bynhack/rc-control/hardware/README.md

# hardware

Boards for the cars (KiCad). 車上用的電路板 · 车上用的电路板

- [`x2201-carrier`](x2201-carrier): a passive carrier board for the X2201 (极客者 1:22 crawler).

Docs: [English](../docs/en/hardware.md#x2201-carrier-board) · [繁體中文](../docs/zh-TW/hardware.md#x2201-轉接板) · [简体中文](../docs/zh-CN/hardware.md#x2201-转接板)
