bynhack/rc-control/docs/en/development.md

# Development

**English** | [繁體中文](../zh-TW/development.md) | [简体中文](../zh-CN/development.md)

## Firmware layout

All in [`firmware/wheel-esp32/main`](../../firmware/wheel-esp32/main):

| File | Role |
|---|---|
| `main.c` | Boot, USB host, and the hand-off from the wheel to the driving model |
| `wheel.c` | Parses the wheel base's HID reports, by VID:PID |
| `control.c` | The driving model and every safety rule. The radios only read `control_output()` |
| `radio.c` | Cars, settings in NVS, and the handling every radio goes through |
| `crsf.c` | ExpressLRS (CRSF) sender |
| `multi.c` | MULTI 4-in-1 sender, serial or PPM |
| `remote.c` | Toy remote through the MCP4728 DAC, and the serial console |
| `ffb.c` | Force feedback (USB PID) |
| `sound.c` | Engine sound synthesis |
| `display_p4.c`, `dash_p4.c`, `ui_p4.h` | Settings screens, instrument clusters, on-screen text in both languages |

`components/usb_host_hid` is a copy of Espressif's usb_host_hid 1.2.1 with one addition, explained under [Force feedback](#force-feedback).

### The signal path

```
wheel.c → control.c (driving model, safety) → radio.c (handling) → crsf.c / multi.c / remote.c
```

A new way of reaching a car only needs a sender that reads `control_output()`, passes it through `radio_steering()` and `radio_throttle()`, and turns the resulting −1…+1 into its own signal. Add it to `radio_kind_t` in `radio.h`, and it gets cars, handling, reverse and the safety rules for free.

### Responsiveness comes first

Nothing may delay the radio. The senders run on core 1 at the highest priorities:

| Task | Core | Priority |
|---|---|---|
| `crsf` | 1 | 10 |
| `multi` | 1 | 9 |
| `sound` | 0 | 6 |
| `ffb` | 0 | 4 |
| `remote` | 1 | 4 |
| `usb_lib` | 0 | 2 |
| `remote_con` (serial console) | 1 | 2 |
| `ui` | 1 | 1 |

The tuning page and the console sit below every sender, so they can't slow the car's response down. A simulated wheel (`w`) is ignored whenever the real wheel has sent data within the last 0.5 s.

### Force feedback

The force feedback reports have to go out on the HID interface's interrupt OUT endpoint (0x03 on the R5). If you send them with SET_REPORT on the control pipe, the R5 answers OK and does nothing. ESP-IDF's usb_host_hid doesn't support OUT endpoints, so `components/usb_host_hid` adds `hid_host_device_send_output_report()`. The effects also need their direction enabled and set to 90° (the X axis); otherwise the spring and damper have no force.

## Serial console

The console is on the log port ("USB TO UART", 115200), one command per line:

| Command | Does |
|---|---|
| `w <steer> <gas> <brake>` | A simulated wheel sample (−1…1, 0…1, 0…1) through the same driving model as the real wheel. Send it every 50 ms. Ignored while the real wheel has sent data within 0.5 s |
| `k start` / `k up` / `k down` / `k stop` | Ignition, gear up, gear down, emergency stop |
| `d <A> <B>` | Set the two DAC codes directly (0–4095). Goes back to the wheel after 1.5 s without a new one |
| `x` | Go back to the wheel at once |
| `name <text>` | Rename the active car |
| `kind <0–3>` | The active car's radio: 0 ELRS, 1 4-in-1 serial, 2 4-in-1 PPM, 3 toy remote |
| `dead <left> <right> <forward> <reverse>` | The active car's steering and throttle dead bands, in thousandths |

## Tuning page

[`tools/remote_tune.html`](../../firmware/wheel-esp32/tools/remote_tune.html) is a bench page that talks to the console. Open it in Chrome, which has Web Serial, served from a local server:

```bash
python3 -m http.server 8765 --bind 127.0.0.1 --directory firmware/wheel-esp32/tools
```

Open http://localhost:8765/remote_tune.html and press Connect (連接 P4).

- **Simulated driving** (模擬駕駛): drag the wheel, press the pedals, start the engine and shift. The keyboard works too: A/D steer, W/S throttle and brake, Enter starts the engine, Q/E shift, Space is the emergency stop. It goes through the same path as the real wheel and shows the engine, gear, speed and output.
- **Fine-tune DAC** (精調 DAC): a zoomable axis per DAC channel (⌘ or Ctrl + scroll, or pinch). Each scroll step moves the output by ±1, or ±10 with Shift. You mark each channel's ends and dead band edges on it. See [Converting a toy remote](toy-remote.md#calibration).

When you're done, press Disconnect (斷開). Otherwise the page keeps the serial port and flashing fails.

## Fonts and dashboard images

- **Fonts**: `main/fonts/gen_fonts.sh <font dir>` regenerates the bitmap fonts with `lv_font_conv` (needs Node). The CJK fonts only contain the characters that appear in the sources, so run it after you add on-screen text. The font directory needs Noto Sans SC Medium, plus Saira and Barlow Condensed for the dashboard digits. Download links are at the top of the script.
- **Dashboard images**: the static layers are drawn in `design/render/dash_render.html`. `design/render/build_assets.py` renders them in headless Chrome and writes `main/assets/*.bin`. It needs Google Chrome, Pillow and numpy.

## Desktop app layout

```
src/
  control.rs        control state and every safety rule, independent of the radio
  config.rs         configuration file
  protocol/crsf.rs  CRSF framing and parsing (link stats, device name, module reset)
  backend/elrs.rs   the send thread
  gui/mod.rs        window layout and interaction
  gui/widgets.rs    custom widgets: gauge, steering bar, sliders, signal bars, link history
  gui/theme.rs      colours, dark theme, fonts
  gui/dev.rs        development helpers: snapshots, demo input
  video/rtp.rs      RTP to H.264/H.265 frames (drops broken fragments on loss)
  video/decoder.rs  low-latency FFmpeg decoding to RGBA
  video/mod.rs      receive thread, statistics
  radio/mod.rs      built-in FPV receiver: adapter choice, start, reconnect, status
  wheel.rs          MOZA R5 / T300RS HID reading, report parsing, --probe-wheel
native/             C++ layer: builds Aviateur's receive code, exposes a C API (rcwfb.h)
third_party/aviateur  submodule, GPL-3.0
vendor/             ffmpeg-sys-next 9.0.1 with Windows D3D stubs ([patch.crates-io])
scripts/            Windows: build, deploy DLLs, bind the 8812AU to WinUSB
```

`cargo test` runs the unit tests for the protocol, the mapping, the safety rules and the wheel report parser. They don't need any hardware.

### Environment variables for UI work

- `RC_CONTROL_SNAPSHOT=out.bmp`: about 1.5 s after start, the app saves the window to an image. It draws the image itself, so no screen recording permission is needed.
- `RC_CONTROL_DEMO=steer,throttle[,low|mid|high]`: fake input for checking the gauges, values −1 to 1. It is **disabled as soon as a device is connected**, so pair it with a port that doesn't exist:

```bash
printf '[elrs]\nport = "/dev/none"\n' > /tmp/demo.toml
RC_CONTROL_DEMO="0.45,0.85,high" RC_CONTROL_SNAPSHOT=/tmp/ui.bmp ./target/release/rc-control --config /tmp/demo.toml
```

### Desktop app build notes

- `vendor/ffmpeg-sys-next-9.0.1`: when bindgen parses `<d3d11.h>`, it pulls in `__tile1024i_str` from `amxintrin.h`, whose `packed` + `align` combination rustc rejects (E0587 / E0080). Empty d3d11 / d3d12 / d3d9 / dxva2 stubs in `hwcontext_stubs` avoid it, used through `[patch.crates-io]`.
- MinGW fixes for Aviateur are applied to copies of the files at build time, so the submodule stays unchanged (see `patch_staged` in `native/CMakeLists.txt`):
  - MinGW already has `clock_gettime` (winpthreads), so the inline one in `net_compat.h` is only used elsewhere.
  - The weak getopt globals in `compat/getopt.h` are defined twice by the PE linker, so they are left out on MinGW.
  - `net_compat.h` blanks `__attribute__` on Windows, which drops `packed` from the wfb-ng headers, and the stand-in only restored 1-byte packing for MSVC. MinGW then padded `wblock_hdr_t` (16 bytes instead of 9) and every frame failed to decrypt. `wifibroadcast.hpp` now gets `#pragma pack` on every Windows compiler.
- An upstream fix, applied the same way: Aviateur doesn't close UDP 8001 when the link stops, and starting it again in the same process crashes. The copied `tx_frame.cpp` gets the missing close.
- `native/CMakeLists.txt` only passes `/utf-8` to MSVC. `build.rs` links static libstdc++ / gcc_eh and ws2_32 for MinGW.

## Protocol notes

- **CRSF**: address `0xEE`, CRC8 polynomial `0xD5`. Channel values 172 / 992 / 1811 are 988 / 1500 / 2012 µs. ELRS only sends channels 1–4 at full resolution.
