bynhack/rc-control/firmware/wheel-esp32/enclosure/out/camera_pod_preview.png

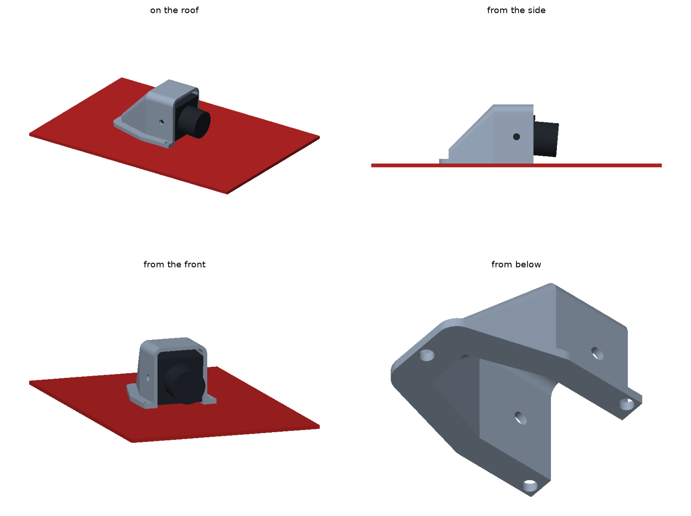
firmware/wheel-esp32/enclosure/out/camera_pod_preview.png
