bynhack/rc-control/firmware/wheel-esp32/enclosure/out/minicar_cage_preview.png

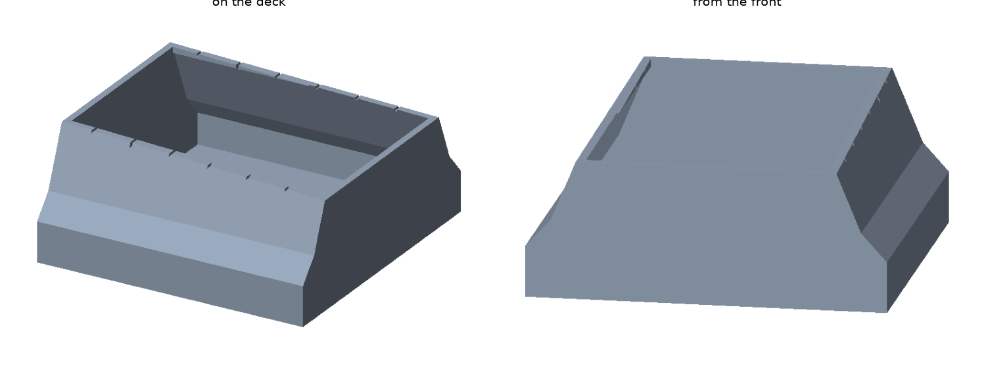
firmware/wheel-esp32/enclosure/out/minicar_cage_preview.png
