bynhack/rc-control/firmware/wheel-esp32/enclosure/out/minicar_mount_preview.png

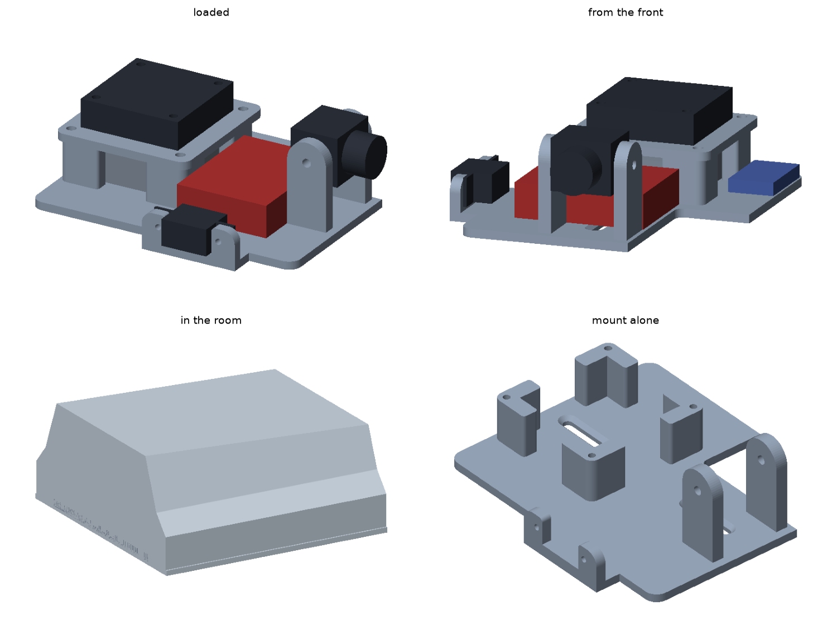
firmware/wheel-esp32/enclosure/out/minicar_mount_preview.png
