bynhack/rc-control/firmware/wheel-esp32/enclosure/out/p4_preview.png

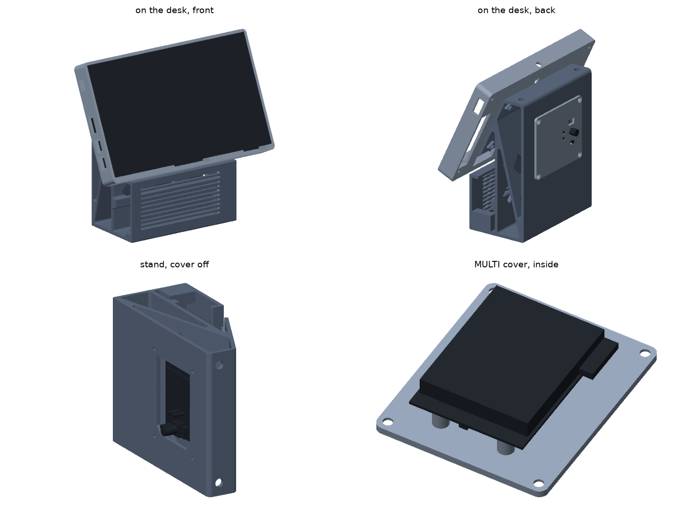
firmware/wheel-esp32/enclosure/out/p4_preview.png
