bynhack/rc-control/firmware/wheel-esp32/enclosure/out/p4_stand_layer.png

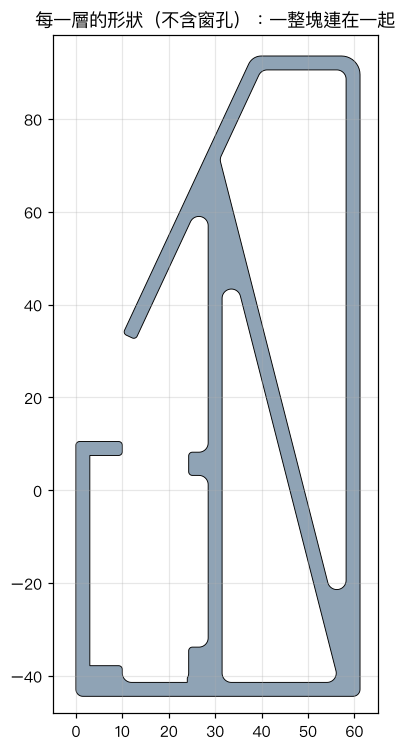
firmware/wheel-esp32/enclosure/out/p4_stand_layer.png
