bynhack/rc-control/firmware/wheel-esp32/enclosure/out/vtx_preview.png

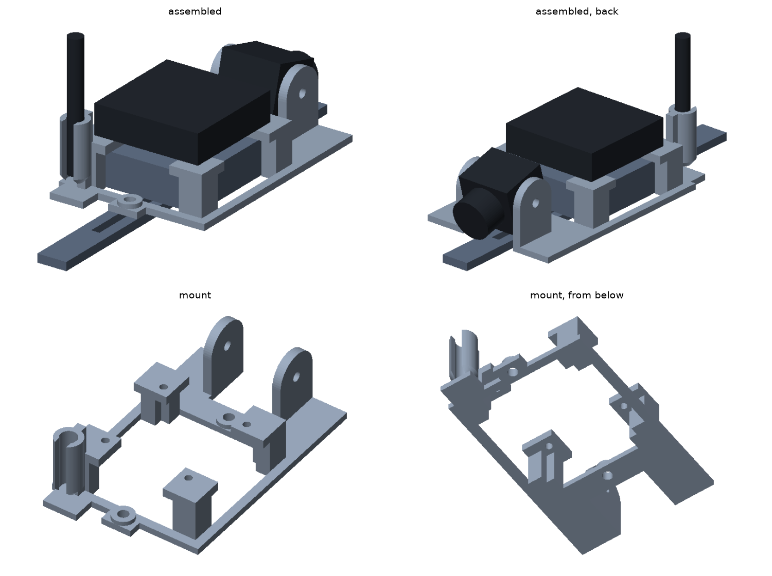
firmware/wheel-esp32/enclosure/out/vtx_preview.png
