bynhack/rc-control/firmware/wheel-esp32/enclosure/out/wifilink_preview.png

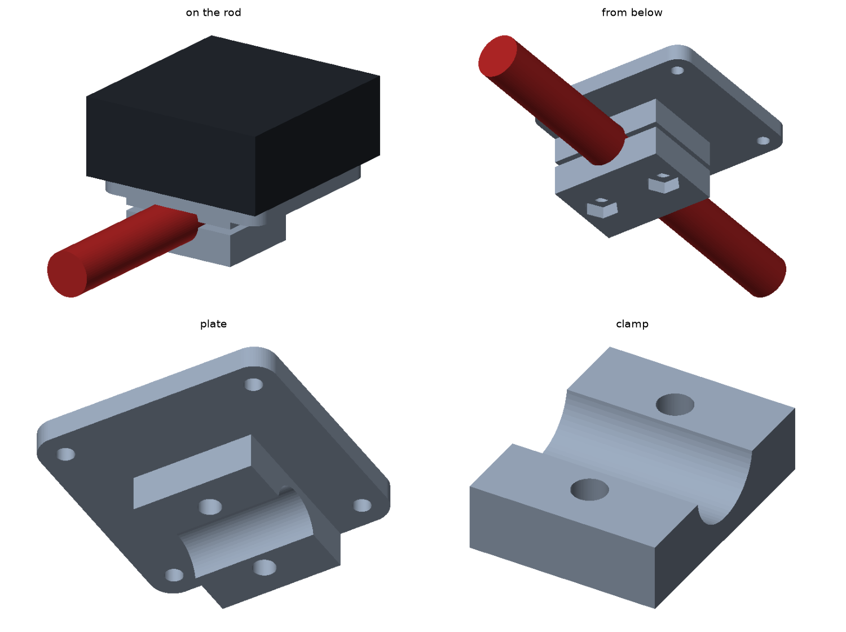
firmware/wheel-esp32/enclosure/out/wifilink_preview.png
