bynhack/rc-control/firmware/wheel-esp32/enclosure/out/p4_stand.stl

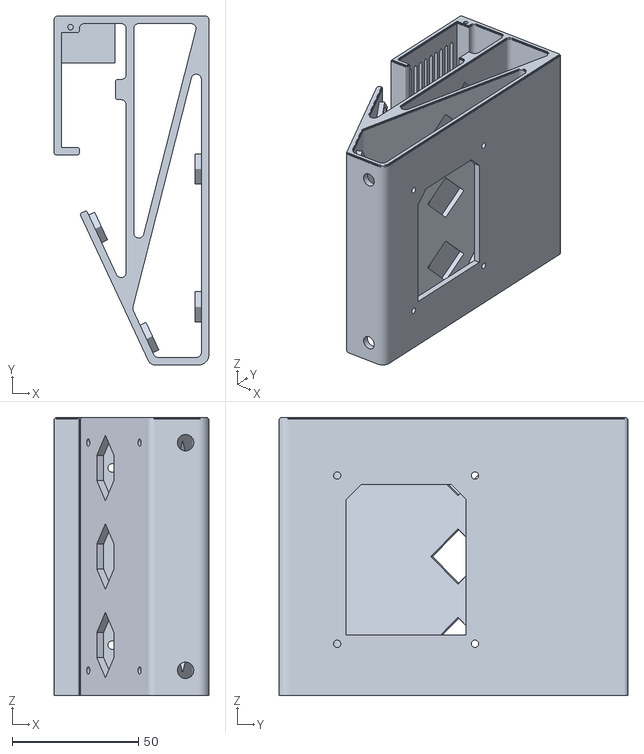
[picture p10: CAD file, 2026-11-02]
firmware/wheel-esp32/enclosure/out/p4_stand.stl
61.2 x 138.0 x 110.0
