bynhack/rc-control/firmware/wheel-esp32/enclosure/out/camera_pod.stl

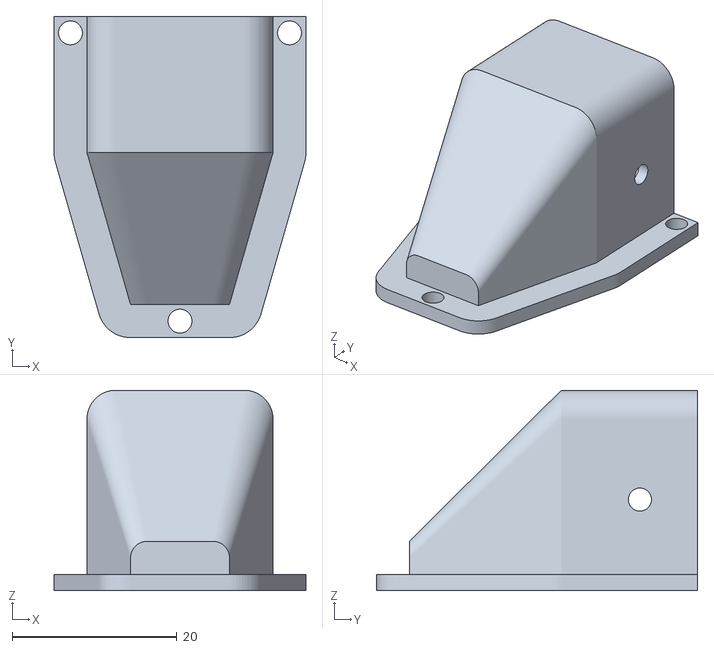
[picture p11: CAD file, 2026-10-31]
firmware/wheel-esp32/enclosure/out/camera_pod.stl
30.6 x 39.0 x 24.3
