bynhack/rc-control/firmware/wheel-esp32/enclosure/out/minicar_fan_cap.stl

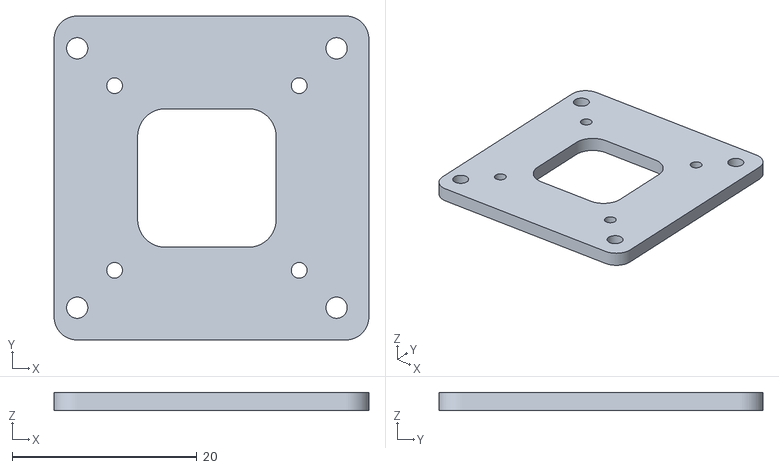
[picture p12: CAD file, 2026-10-31]
firmware/wheel-esp32/enclosure/out/minicar_fan_cap.stl
34.1 x 35.1 x 2.00
