bynhack/rc-control/firmware/wheel-esp32/enclosure/out/minicar_cage.stl

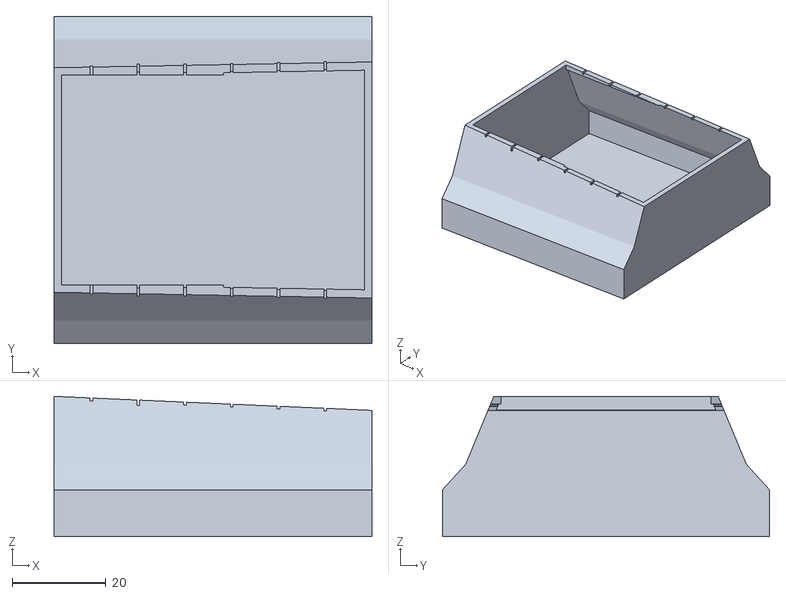
[picture p13: CAD file, 2026-10-31]
firmware/wheel-esp32/enclosure/out/minicar_cage.stl
68.0 x 70.0 x 30.0
