bynhack/rc-control/firmware/wheel-esp32/enclosure/out/p4_multi_cover.stl

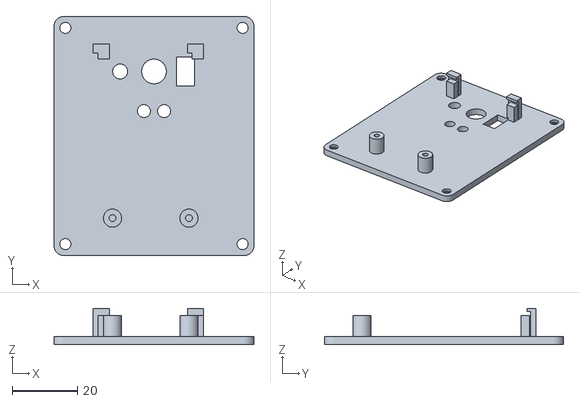
[picture p14: CAD file, 2026-10-31]
firmware/wheel-esp32/enclosure/out/p4_multi_cover.stl
61.5 x 73.5 x 11.1
