bynhack/rc-control/firmware/wheel-esp32/enclosure/out/p4_tray.stl

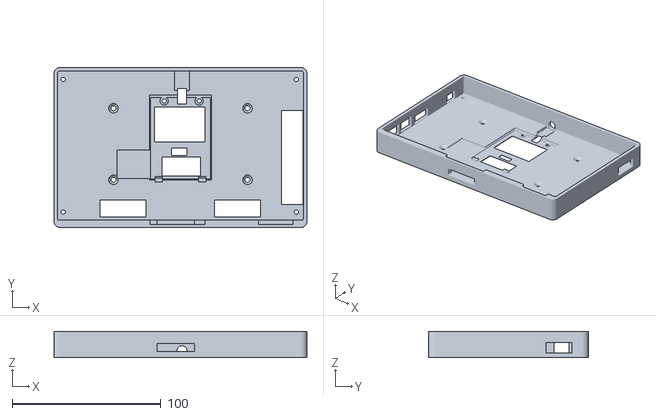
[picture p15: CAD file, 2026-10-31]
firmware/wheel-esp32/enclosure/out/p4_tray.stl
169.9 x 107.4 x 17.7
