bynhack/rc-control/firmware/wheel-esp32/enclosure/out/wifilink_clamp.stl

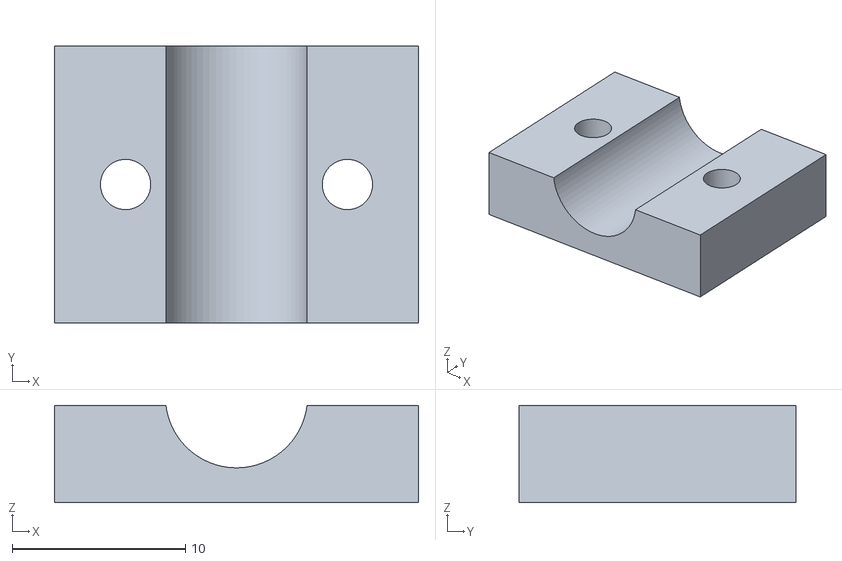
[picture p16: CAD file, 2026-10-31]
firmware/wheel-esp32/enclosure/out/wifilink_clamp.stl
21.0 x 16.0 x 5.60
