bynhack/rc-control/firmware/wheel-esp32/enclosure/out/minicar_mount.stl

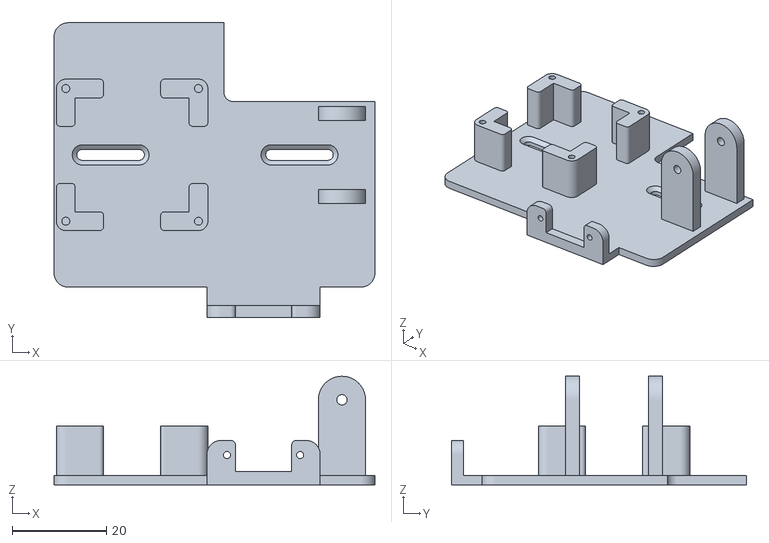
[picture p17: CAD file, 2026-10-31]
firmware/wheel-esp32/enclosure/out/minicar_mount.stl
68.0 x 62.4 x 23.0
