bynhack/rc-control/firmware/wheel-esp32/enclosure/out/vtx_mount.stl

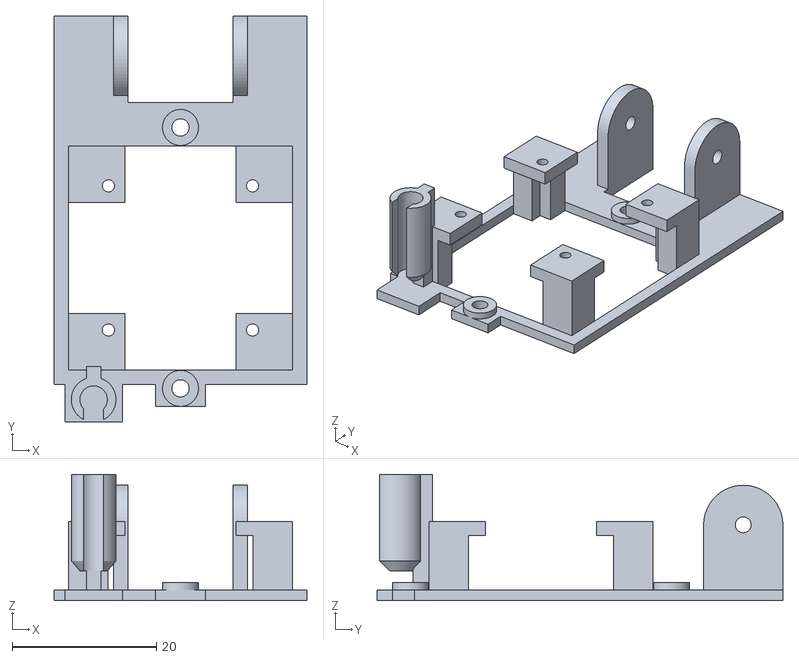
[picture p18: CAD file, 2026-10-31]
firmware/wheel-esp32/enclosure/out/vtx_mount.stl
35.1 x 56.3 x 17.5
