bynhack/rc-control/firmware/wheel-esp32/enclosure/out/wifilink_plate.stl

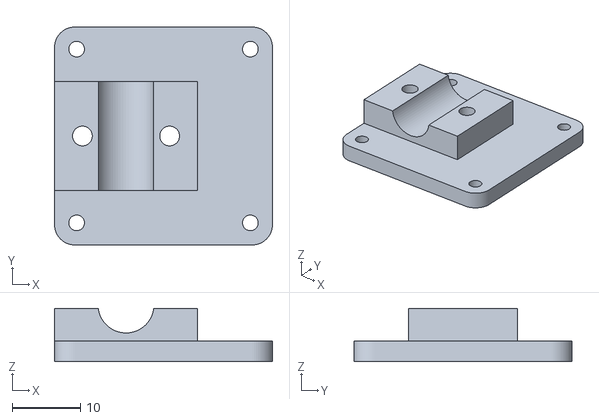
[picture p19: CAD file, 2026-10-31]
firmware/wheel-esp32/enclosure/out/wifilink_plate.stl
32.0 x 32.0 x 7.80
