bynhack/rc-control/hardware/x2201-carrier/x2201-carrier.pdf

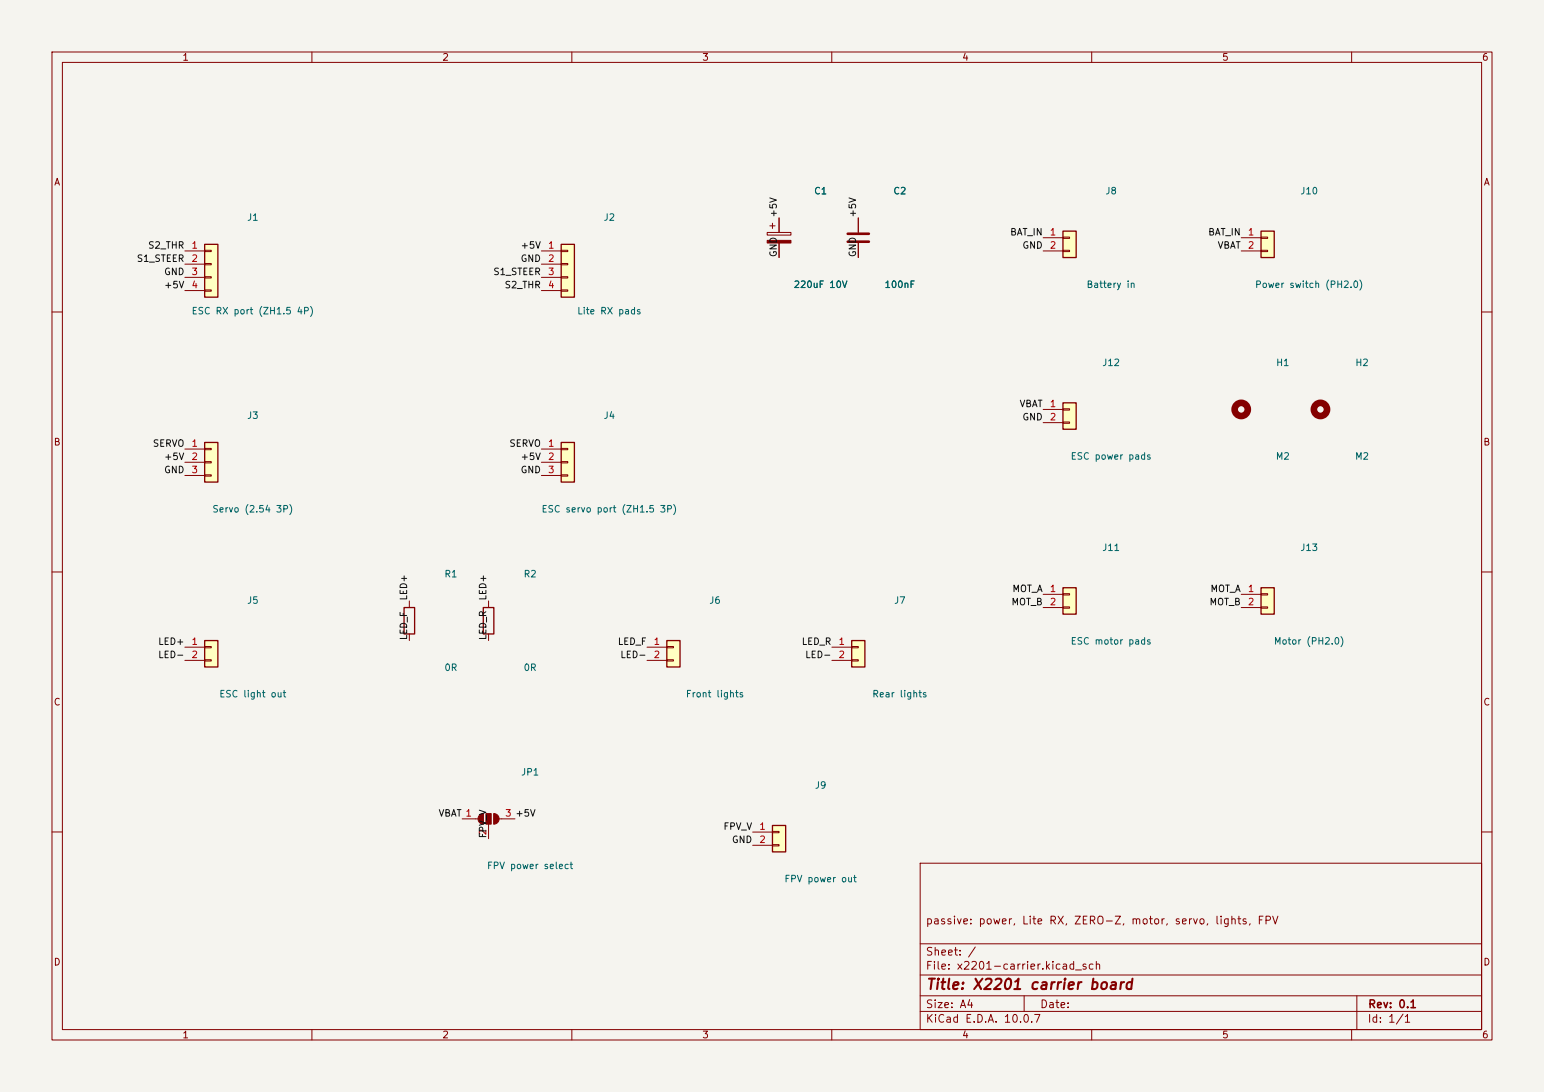
[picture p20: page 1]

passive: power, Lite RX, ZERO-Z, motor, servo, lights, FPV

Size: A4 | Rev: 0.1
KiCad E.D.A. 10.0.7 | Id: 1/1
