bynhack/rc-control/hardware/x2201-carrier/x2201-carrier.kicad_sch

## KiCad design hardware/x2201-carrier/x2201-carrier.kicad_sch (2026-11-02)

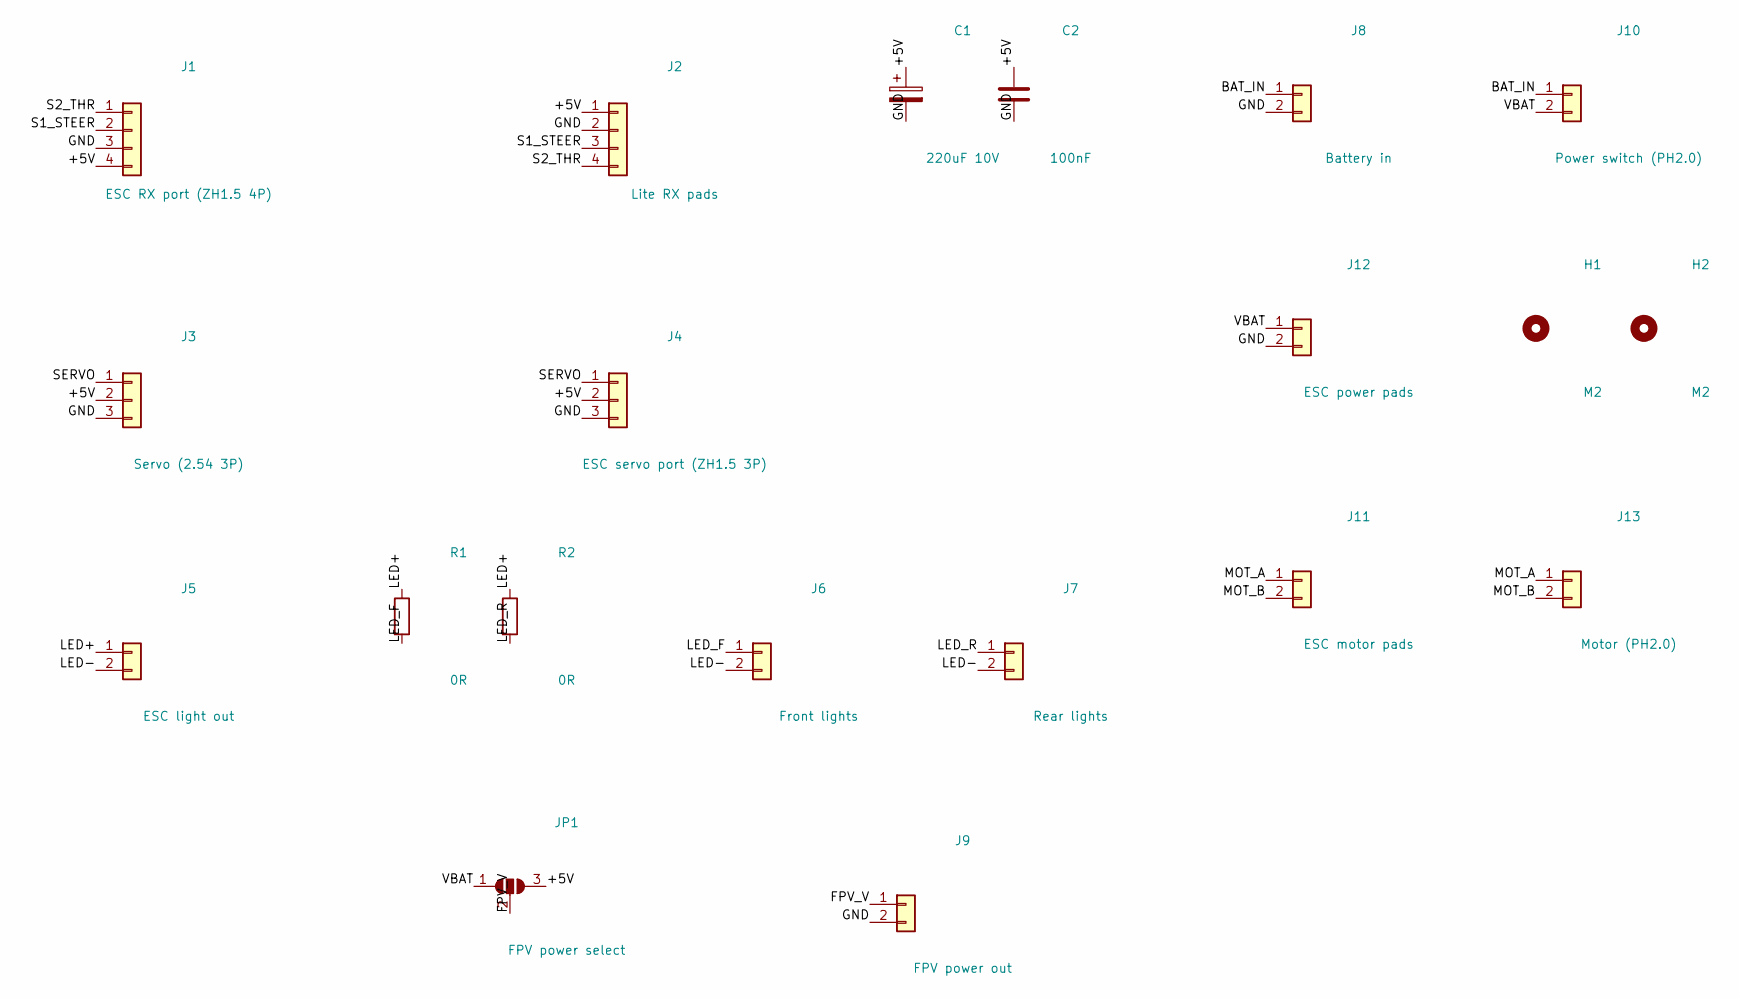
[picture p21: schematic x2201-carrier.kicad_sch]

Parts:
C1: 220uF 10V; CP_EIA-7343-20_Kemet-V_HandSolder
C2: 100nF; C_0805_2012Metric_Pad1.18x1.45mm_HandSolder
H1, H2: M2; MountingHole_2.2mm_M2_Pad
J1: ESC RX port (ZH1.5 4P); JST_ZH_B4B-ZR_1x04_P1.50mm_Vertical
J2: Lite RX pads; PinHeader_1x04_P2.54mm_Vertical
J3: Servo (2.54 3P); PinHeader_1x03_P2.54mm_Vertical
J4: ESC servo port (ZH1.5 3P); JST_ZH_B3B-ZR_1x03_P1.50mm_Vertical
J5: ESC light out; PinHeader_1x02_P2.54mm_Vertical
J6: Front lights; PinHeader_1x02_P2.54mm_Vertical
J7: Rear lights; PinHeader_1x02_P2.54mm_Vertical
J8: Battery in; JST_PH_B2B-PH-K_1x02_P2.00mm_Vertical
J9: FPV power out; PinHeader_1x02_P2.54mm_Vertical
J10: Power switch (PH2.0); JST_PH_B2B-PH-K_1x02_P2.00mm_Vertical
J11: ESC motor pads; PinHeader_1x02_P2.54mm_Vertical
J12: ESC power pads; PinHeader_1x02_P2.54mm_Vertical
J13: Motor (PH2.0); JST_PH_B2B-PH-K_1x02_P2.00mm_Vertical
JP1: FPV power select; SolderJumper-3_P1.3mm_Open_Pad1.0x1.5mm
R1, R2: 0R; R_0805_2012Metric_Pad1.20x1.40mm_HandSolder

Connections:
+5V: C1.1, C2.1, J1.4, J2.1, J3.2, J4.2, JP1.3 (B)
BAT_IN: J8.1, J10.1
FPV_V: J9.1, JP1.2 (C)
GND: C1.2, C2.2, J1.3, J2.2, J3.3, J4.3, J8.2, J9.2, J12.2
LED+: J5.1, R1.1, R2.1
LED-: J5.2, J6.2, J7.2
LED_F: J6.1, R1.2
LED_R: J7.1, R2.2
MOT_A: J11.1, J13.1
MOT_B: J11.2, J13.2
S1_STEER: J1.2, J2.3
S2_THR: J1.1, J2.4
SERVO: J3.1, J4.1
VBAT: J10.2, J12.1, JP1.1 (A)
