bynhack/rc-control/firmware/wheel-esp32/main/display.h

// The dashboard and settings on the Waveshare 7B's 7" 1024x600 touch panel
// (display_p4.c, dash_p4.c).
#pragma once

#include <stdbool.h>
#include <stdint.h>

#include "control.h"
#include "crsf.h"
#include "multi.h"
#include "radio.h"
#include "wheel.h"

typedef struct {
    bool wheel;        // a parsed wheel report arrived recently
    uint16_t vid, pid; // attached HID device, 0 when none
    float rate;        // reports per second
    wheel_axes_t axes; // raw pedals and steering, valid when wheel is true
    control_view_t ctl;
    crsf_status_t radio;
    multi_status_t multi;
    radio_config_t cfg;
    int button; // last pressed button number while it is shown, else 0
} display_state_t;

void display_init(void);

// Safe to call from any task; draws on the next LVGL refresh.
void display_show(const display_state_t *s);
