bynhack/rc-control/firmware/wheel-esp32/main/ffb.h

// Force feedback on the wheel base, through the standard USB PID reports
// (what DirectInput games use; the MOZA R5 descriptor has them all).
//
// Three condition effects stay running: a centring spring, a damper and an
// end stop. The
// driving code sets their strengths every frame (ffb_set); a task pushes
// changes to the base. The overall strength is the base's device gain,
// set on the dashboard (ui_ffb_get / ui_ffb_set in radio.h).
#pragma once

#include <stdbool.h>

#include "usb/hid_host.h"

// After hid_host_device_start(): resets the base's effects and creates ours.
void ffb_attach(hid_host_device_handle_t dev);
void ffb_detach(void);

// 0..1 each: centring spring stiffness and damping.
void ffb_set(float spring, float damper);

// End stop at the car's full lock: past -edge..+edge of the steering axis
// the wheel is pushed back hard. 1 (the default) = none.
void ffb_set_stop(float edge);

// Where the spring pulls to, -1..1 of the steering axis; 0 normally.
void ffb_set_centre(float centre);

// Bring the wheel back to the centre (after the steering trim is saved with
// the wheel held off centre). While ffb_recentring(), the driving code pulls
// it there instead of its own ffb_set(), and calls ffb_recentre_stop() once
// it has settled; it gives up by itself after a few seconds.
void ffb_recentre(void);
void ffb_recentre_stop(void);
bool ffb_recentring(void);
