bynhack/rc-control/(commit log)

2026-10-22 Initial rc-control: ELRS/RC2 control, dashboard GUI, video display
    - Shared control layer with all safety rules (arming, heartbeat watchdog,
    e-stop, speed tiers) used by both backends.
    - ELRS backend: CRSF over the USB-patched AION Nano, link stats, resets.
    - MR-RC2 backend: reverse-engineered protocol with 2-char pipelining,
    change-driven writes, telemetry polling.
    - Native egui dashboard (PingFang/YaHei + DIN/Bahnschrift), gauge, link
    history, dev snapshot/demo hooks.
    - Video: RTP H.264/H.265 depacketizer, low-latency FFmpeg decode; the
    center panel switches to a video layout while frames arrive.
    - GPL-3.0, since the radio receive side will build on Aviateur.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
    [config.rs, control.rs, main.rs]
2026-10-23 Built-in video radio: link Aviateur's wfb-ng receive path
    rc-control now drives the RTL8812AU-class adapter itself, so Aviateur no
    longer has to run alongside it.
    - third_party/aviateur as a pinned submodule (only 3rd/devourer needed).
    - native/: CMake builds Aviateur's src/wifi unmodified against a stand-in
    gui_interface.h, plus a small C API (rcwfb.h). build.rs drives it and
    links devourer, libusb and libsodium.
    - Upstream fix applied to the staged copy: TxFrame never closed its UDP
    8001 socket, so restarting the link in-process threw and aborted.
    - radio module: picks only recognised adapters (the device list covers
    every USB device), pre-checks UDP 8001, restarts after unplug or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
    [build.rs, config.rs, main.rs]
2026-10-23 Show TX ONLY instead of NO LINK when an ELRS module never replies
    A module wired CRSF to TXD only (no RX return) receives control fine but
    can never report link stats, which looked like a dead link. The ELRS
    backend now records whether any frame came back; after 3 s of silence
    the link panel says transmit-only and how to wire RXD.
2026-10-23 Steering/throttle reverse toggles in the control panel
    Direction flips now live in shared runtime state per backend and are
    applied at the last step before sending, so the dashboard keeps showing
    the commanded direction. The toggles take effect immediately and are
    saved to rc-control.toml with toml_edit, changing only those keys and
    keeping the rest of the file and its comments.
    [config.rs, main.rs]
2026-10-23 Merge Windows work: T300RS wheel input, probes, MinGW build
    Brought over from the Windows debugging copy (based on b5d2e62), where
    the wheel and the MinGW build were verified on hardware:
    - src/wheel.rs: Thrustmaster T300RS read as raw HID (044f:b66e, report
    07; steering ±0x3800 around 0x8000, pedals 10-bit, released = 1023).
    The GUI lets fresh wheel input (< 250 ms) drive steering and throttle,
    with an input-side invert and deadzone in [wheel].
    - --probe-elrs, --probe-rc2, --probe-wheel diagnostics.
    - MinGW (MSYS2 UCRT64) build: static libstdc++/gcc_eh, ws2_32/winmm,
    /utf-8 only for MSVC, vendored ffmpeg-sys-next with D3D stubs, hidapi.
    - scripts/: build, deploy DLLs, bind RTL8812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
    [build.rs, config.rs, main.rs, wheel.rs]
2026-10-23 Remove the MR-RC2 scheme; ELRS is the only control path
    The MR-RC2 hardware fell short on latency and range in testing, so it is
    dropped entirely: its protocol and backend, the scheme switch
    (BackendKind, the `backend` key, --backend), lights, RC2 telemetry,
    --probe-rc2 and the CH340 driver script. The top bar now shows a fixed
    ELRS badge with the CRSF line rate, and direction flips are a single
    setting saved under [elrs].
    Existing configs that still carry `backend` or an [rc2] section load as
    before; the extra keys are ignored (covered by a test).
    [config.rs, control.rs, main.rs]
2026-10-25 Pack wfb-ng headers on MinGW so video frames decrypt
    net_compat.h blanks __attribute__, and the stand-in header only restored
    1-byte packing for MSVC. MinGW then padded wblock_hdr_t, so every frame
    failed with "Unable to decrypt packet". Also copy avformat-63.dll on deploy.
2026-10-25 Read the MOZA R5 Pro wheel over HID
    The base is 346e:0004. Steering is the unsigned X axis; throttle and
    brake are Z and Rz in the same report. T300RS still works, and auto
    prefers the MOZA base when both are plugged in.
2026-10-25 ESP32-S3 wheel firmware: USB host wheel input and round status screen
    Reads a T300RS or MOZA R5 base over the S3's OTG port, shows steering and
    throttle on a GC9A01 round screen, and dumps descriptor and raw reports for
    unknown HID devices. Nothing is transmitted yet.
2026-10-25 ESP32 wheel firmware: CRSF output, safety logic and MOZA button mapping
    Drives the ELRS TX module over one-wire CRSF on GPIO17 at 250 Hz with the
    PC program's arming, heartbeat and speed-tier rules. MOZA R5: Start arms,
    paddles change the speed tier, P is the emergency stop; pedals swapped to
    right = gas. The round screen shows arm state, speed tier and link quality.
    [control.c, control.h, crsf.c, crsf.h, display.h, main.c, wheel.c, wheel.h]
2026-10-25 wheel-esp32: README with current wiring and the finalised next hardware plan
2026-10-26 wheel-esp32: 3D-printable case for the current hardware
    Parametric manifold3d model: body (prints top down) and bottom plate, no
    supports. Holds the S3 devboard, round screen, a USB-A jack for the wheel
    and the BETAFPV 1W module in a rear bay.
    [body.stl, plate.stl]
2026-10-26 wheel-esp32 case: measured BETAFPV module thickness (20 mm)
    [body.stl, plate.stl]
2026-10-26 wheel-esp32 case: glass pocket centred on the display area
    The panel is a 35.6 circle plus the FPC bump (38.1 overall), and the 32.4
    display area is centred on the circle. The pocket is now that circle plus a
    bump pocket, so the bezel is even all round.
    [body.stl]
2026-10-27 wheel-esp32 case: export the body rotated, not mirrored
    The body was flipped for printing with a mirror, which swapped left and
    right, so the plate's screw holes only lined up with the plate upside down.
    Export it with a 180 degree rotation instead, and add a mirrored plate for
    bodies already printed from the old file. Also keep the board cradles
    0.4 mm clear of the screw columns (one cradle wall clipped the left boss).
    [body.stl, plate-for-mirrored-body.stl, plate.stl]
2026-10-27 wheel-esp32 case: board ledges clear of the header rows, assembly simulator
    The board ledges sat under its corners, where the header rows run, so the
    board would have rested on its header spacers. They now sit under the
    middle of the short edges. Found with viewer_export.py, which checks every
    part pair with exact booleans for the designed, printed-mirrored and wrong
    combinations; viewer.html shows the result in three.js.
    [plate-for-mirrored-body.stl, plate.stl]
2026-10-27 wheel-esp32 case v2: radio-style module bay, 3M-taped screen and MB102
    The BETAFPV module now slides into a 45 x 60 bay at the back with channels
    for its side latches, mating with a header glued in the bay wall. The
    round screen and the MB102 power module are held with 3M foam tape; the
    glass recess follows the FPC fold on the header side. 45 part pairs check
    clean in the assembly simulator.
    [body.stl, plate-for-mirrored-body.stl, plate.stl]
2026-10-27 wheel-esp32 case v2: screen on a taped post, room for Dupont plugs
    The screen's back is now taped onto a post on the plate and the glass
    shows through a glass-shaped opening (circle plus the flat FPC side). The
    board sits 24 mm up so Dupont plugs fit under it. Only the CH340C USB-C and
    the DC jack get openings; the OTG port and the MB102 mini-USB are unused.
    55 part pairs, including the Dupont plugs, check clean.
    [body.stl, plate.stl]
2026-10-27 wheel-esp32: build for the ESP32-P4 7B board as well as the S3
    Per-target sdkconfig defaults; CRSF on GPIO28 (terminal P3) on the P4,
    since the board's UART terminal shares UART0 with the CH343P console. The
    round screen driver is S3-only for now. The P4's default USB host
    peripheral is the high-speed one, wired to the board's USB-A port.
2026-10-27 wheel-esp32: 7-inch dashboard on the ESP32-P4 7B board
    1024x600 LVGL dashboard through Waveshare's BSP (EK79007 panel, GT911
    touch), in the PC program's palette: throttle gauge with speed-tier
    ceiling, steering strip, pedal bars, link quality and channel outputs.
    Touch sets the speed tier and triggers the emergency stop; arming stays on
    the wheel. Also includes sdkconfig.h before the target checks in the
    display sources, which had silently compiled the S3 screen out.
2026-10-28 wheel-esp32: drive a MULTI 4-in-1 module over serial on GPIO30
    The IRX4+ accepts the frames (red LED solid) non-inverted. Protocol is a
    placeholder (AFHDS2A) until the cars are known; wheel button N binds.
    [main.c, multi.c, multi.h]
2026-10-28 wheel-esp32: MULTI set up for Futaba S-FHSS (fine tune -50)
    [body.stl, plate.stl]
2026-10-28 wheel-esp32: MULTI PPM output option (dial mode), AFHDS 2A PWM_SBUS
    PPM on GPIO30 lets the module bind with its own dial and button; that is
    how the MXO RXC42-AG bound. Serial stays the default.
2026-10-28 wheel-esp32: MULTI in PPM mode by default (works with the MXO car)
2026-10-28 wheel-esp32: RADIO setup page on the P4 screen
    Pick ELRS, MULTI serial (with protocol, RX num, fine tune, bind) or MULTI
    PPM (module dial) on the touch screen; saved in NVS. Only the selected
    radio transmits. Reversing is per output. Opening the page disarms.
    [crsf.c, display.h, display_p4.c, main.c, multi.c, multi.h, radio.c, radio.h]
2026-10-28 wheel-esp32: README for the MULTI module and the RADIO page
2026-10-28 wheel-esp32: Chinese dashboard, Simplified by default, Traditional selectable
    Subset bitmap fonts from Noto Sans SC (OFL) with a Montserrat fallback,
    regenerated by main/fonts/gen_fonts.sh. The language switch is on the
    setup page and saved in NVS.
2026-10-28 wheel-esp32: drive like a car: ignition, gears R N 1 2 3, coasting, real brake
    Start is the ignition, the paddles shift R N 1 2 3 (power cap per gear,
    reverse only in R and only from a standstill), lifting off coasts down,
    the brake pedal only brakes. Reverse runs the ESC's brake-neutral-reverse
    handshake by itself. The 7" screen is now laid out like an instrument
    cluster: power and speed gauges, a big gear indicator, warning lamps.
    [control.c, control.h, display_p4.c]
2026-10-28 wheel-esp32: main screen is only the instrument cluster
    Two big gauges, the gear and one notice line. Wheel, pedals, steering and
    the radio link move to a status tab on the setup page; the on-screen
    emergency stop goes (wheel P still stops).
2026-10-28 wheel-esp32: three instrument clusters, swipe to switch
    Sport (glowing rings, gear badge), classic (silver bezels, needles, LCD
    gear) and race (shift lights, big digits, speed bar), in dash_p4.c. Swipe
    left / right on the main screen; the choice is saved. Shared palette,
    fonts and text ids move to ui_p4.h.
2026-10-28 wheel-esp32: obsidian and carbon dashboards from the design concepts
    The static layers (dial faces, ticks, carbon weave, glows) are rendered
    from design/render/dash_render.html by headless Chrome and embedded as
    images (RGB565 dithered backgrounds, ARGB8888 textures); LVGL draws only
    what moves on top: the textured speed arc, needle, digits, gear, shift
    lights. Both show steering: obsidian a top-down car whose front wheels
    and path bend, carbon the lit wings and a turning wheel icon. Swipe
    switches. A 16 MB app partition (nvs unchanged) makes room.
    [partitions_p4.csv]
2026-10-28 wheel-esp32: speed in km/h, notices in the obsidian dial
    The dashboards show the modelled speed in km/h from a top speed set on a
    new Driving tab (saved, default 30); obsidian draws its dial numbers from
    it. Each dashboard places the driver's notices itself: obsidian puts
    "press Start" in place of the number with the engine off, and driving
    notices under it.
2026-10-28 wheel-esp32: force feedback on the MOZA base (USB PID)
    A centring spring and a damper run as PID condition effects; their
    strength follows the modelled speed (light when parked, firmer when
    fast). The overall strength is the base's device gain, set on the
    Driving tab (default 40 %, 0 = off).
2026-10-29 wheel-esp32: screen flip 180 degrees (setting, applied at boot)
    The board has no IMU, so it is a button on the Driving tab; it saves the
    choice and restarts, since the display's rotation is fixed at start.
    [display_p4.c, radio.c, radio.h]
2026-10-29 wheel-esp32: flip the touch panel with the screen
    [display_p4.c]
2026-10-29 wheel-esp32: two-wire full duplex CRSF for the Nano RX-as-TX
    GPIO28 out, GPIO29 in, picked on the ELRS setup page and kept in NVS.
    One wire (BETAFPV) stays the default.
2026-10-29 wheel-esp32: README, how the Nano was flashed as a TX
2026-10-29 wheel-esp32: synthesised engine sound on the P4 speaker
    Starter, idle, revs from speed within the gear, free rev in neutral,
    overrun pops. Volume on the driving tab (default 60 %).
2026-10-29 wheel-esp32: louder engine sound, volume applied to the samples
    The codec's volume tops out at 0 dB; keep it full and scale digitally.
    Default 80 %.
2026-10-29 wheel-esp32: engine sound without the bang on gas changes
    Revs slew-limited like a real engine, load smoothed, firing level glides
    across a block, overrun pops rarer and softer.
2026-10-29 wheel-esp32: a starter that sounds like one
    Geared whine that spins up and labours on each compression, sputters
    before it catches, lets go and freewheels away, then the revs flare and
    settle to idle.
2026-10-29 wheel-esp32: rally car engine sound
    A second voice, picked on the driving tab: turbo four with a lumpy idle,
    turbo whistle and blow-off flutter, anti-lag bangs and crackle, flat-shift
    ignition cut with a bang, downshift blips, dog-box and diff whine, gravel.
    [display_p4.c, radio.c, radio.h]
2026-10-29 wheel-esp32: BMW M4 engine sound, voices described by their parts
    voice_t now says how many cylinders and how much turbo, blow-off, shift
    cut, blip, dog box and gravel a car has; the rally voice is unchanged.
    The M4 is a twin-turbo straight six. Three buttons on the driving tab.
2026-10-29 wheel-esp32: engine sound without the crackle
    25-40 % of the samples went into the soft clip, which on the little
    speaker sounded broken. High-pass at 150 Hz (the speaker can't play
    lower), and a limiter instead of clipping.
    [sound.c]
2026-10-29 wheel-esp32: car profiles
    Six cars, each with its own radio, top speed and engine sound, picked on
    a new first setup tab; the radio and driving tabs edit the active car.
    The old single setting becomes car 1. Rename with the on-screen keyboard;
    the active car's name shows next to the settings button.
2026-10-29 wheel-esp32: README, a plain ELRS receiver as a 2-channel PWM receiver
2026-10-30 wheel-esp32: working force feedback, steering trim, Nano TX on GPIO30
    Force feedback on the MOZA R5 never reached the wheel. The R5 acknowledges
    output reports sent with SET_REPORT on the control pipe and then ignores
    them, so they now go on the HID interrupt OUT endpoint. usb_host_hid has no
    OUT support, so it is vendored in components/usb_host_hid with
    hid_host_device_send_output_report(). Effects also need their direction
    enabled and set to 90 degrees; with it off, the spring and damper produce
    no force.
    Steering trim per car, like the knob on a stock radio. Start it from the
    driving tab: a panel on the dashboard shows the wheel position live. Hold
    the wheel where the car runs straight a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
2026-10-31 wheel-esp32: per-car handling tab, 3D-printed parts
    Handling (new 操控 tab, saved per car, garage version 4; older garages
    load with the defaults):
    - steering range: full lock at N of the wheel's 900 degrees, with a
    force feedback end stop past it (a third effect, a spring with a dead
    band) and the centring spring scaled to match
    - centre expo
    - left and right end points, set with the wheel on the dashboard
    - throttle start point, forward and reverse, set with the pedal: the
    output starts where the ESC starts to move the car, so a gear cap no
    longer stretches its dead band
    - the steering trim moves here; the dashboard panel now sets all three
    Printed parts: the P4 desk case and st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
    [camera_pod.stl, minicar_cage.stl, minicar_fan_cap.stl, minicar_mount.stl, p4_multi_cover.stl, p4_stand.stl, p4_tray.stl, vtx_mount.stl]
2026-11-02 wheel-esp32: drive a toy car's own remote, shared dead bands
    A fourth radio kind, REMOTE: the toy remote's steering and throttle pots
    are replaced by an MCP4728 DAC on the board's I2C bus. The output is held
    between the remote's measured full points (outside them its chip misreads
    the pots) and the rest position is stored in the DAC's EEPROM, so the car
    doesn't move at power-up. Only the car set to REMOTE drives it.
    Handling is now the same for every radio kind: each kind only turns -1..1
    into its own signal. A steering dead band (left/right, per car) joins the
    throttle's, which is renamed from start point and allowed up to 80 %.
    Both are set with the wheel or pedal on the dashboard.
    A ben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
2026-11-02 hardware: X2201 carrier board schematic
    A passive board for the X2201 conversion, no chips: battery, power switch,
    the ZERO-Z ESC, its motor, the Lite RX, the servo, lights and FPV power
    meet on it instead of a nest of wires. Connections only, generated by
    gen_sch.py; the layout waits for the parts' measurements.
    [x2201-carrier.kicad_sch]
2026-11-02 enclosure: P4 stand takes the 100 x 45 two-driver speaker
    The speaker slides in from the stand's open end into a slot behind the
    grille, with a stop at the far end and a self-tapping screw at the near
    one, instead of four screws through its tabs.
    [p4_stand.stl]
2026-11-02 docs: README for publishing under GPL-3.0
    The top README now introduces the whole project (desktop app, ESP32
    controller, hardware) and lists the license of every third-party part it
    carries. The firmware README is reorganised around the P4 board as it is
    today: wiring, driving, the per-car handling shared by every radio kind,
    ELRS / MULTI / toy remote, force feedback, the bench tools and the
    printed parts; the purchase plans are gone and the S3 build is marked as
    broken. A short README for hardware/. LICENSE no longer in .gitignore
    (it was tracked anyway); .claude/ is.
2026-11-02 wheel-esp32: P4 only, the ESP32-S3 version is gone
    The hardware is the Waveshare P4 7B from here on. Gone: the round GC9A01
    screen driver, the S3 pins and sdkconfig, its component rules, and the S3
    case with its viewer. The other printed parts imported their helpers from
    that case's script; those now live in enclosure/cad.py.
    The P4 is the default target, so a plain `idf.py build` builds it; the
    separate build-p4 / sdkconfig.p4 setup is no longer needed.
    [body.stl, plate.stl]
2026-11-02 docs: rewrite the docs in English, Traditional and Simplified Chinese
    The README is a short front page now, and the details are split into
    seven pages per language under docs/: the wheel controller, driving and
    handling, radios, converting a toy remote, hardware, the desktop app and
    development. The firmware and hardware READMEs point to them.
    The toy remote page describes the conversion with a socket and a 3PDT
    switch, so the remote still works on its own batteries, and corrects the
    old note that the pots' middle pins were cut.
